Yury-MonZon/MZButtons/MZButtons/used_pins.jpg

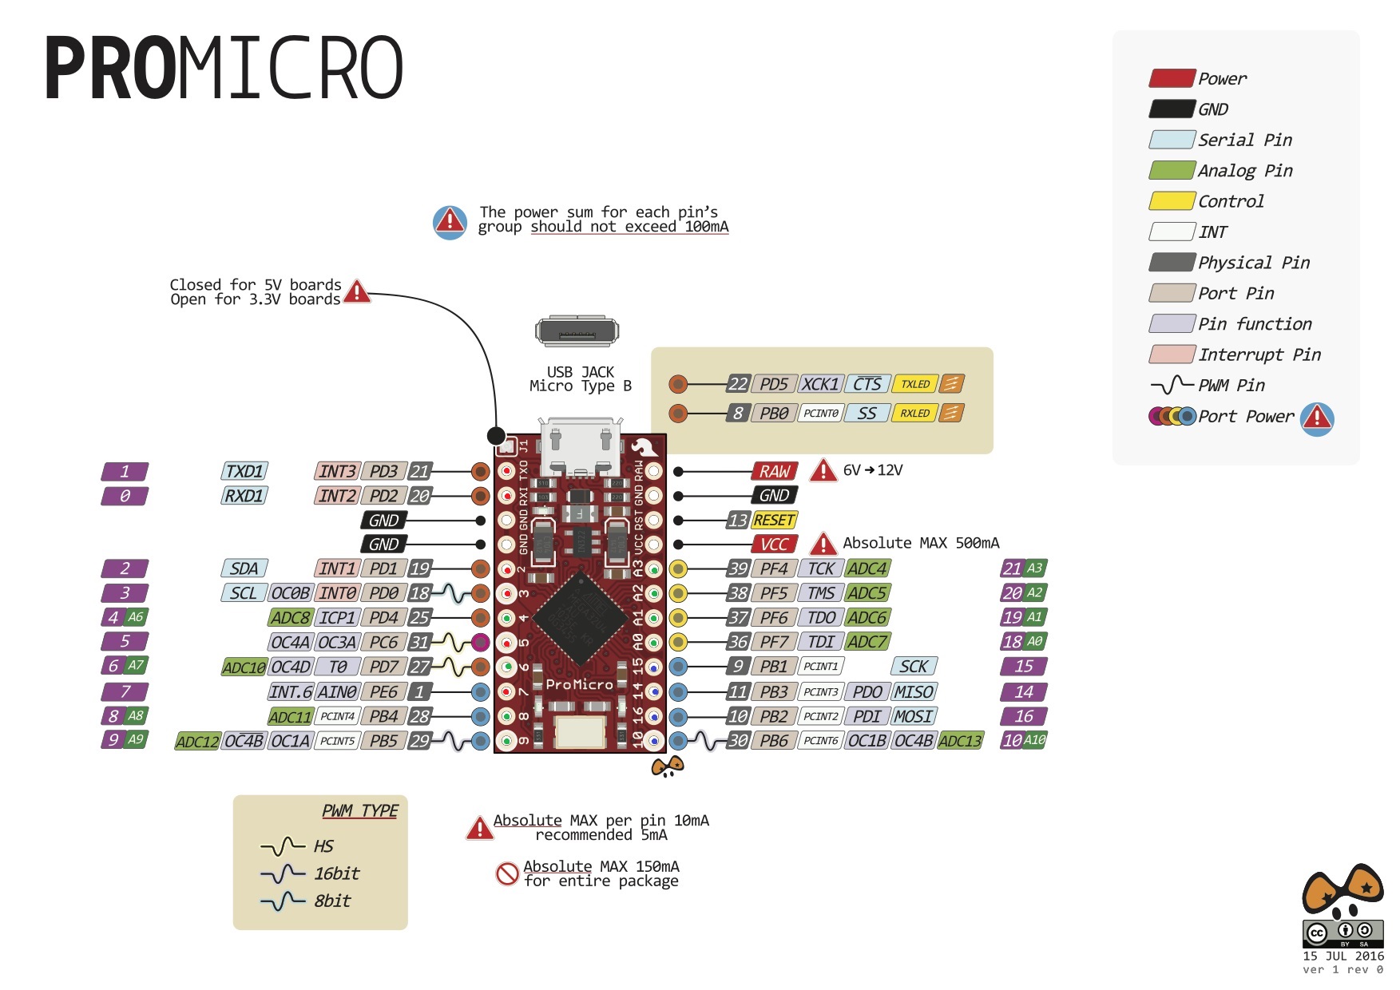
MZButtons/used_pins.jpg
