Yury-MonZon/MZButtons/Photos/IMG_20180401_122430.jpg

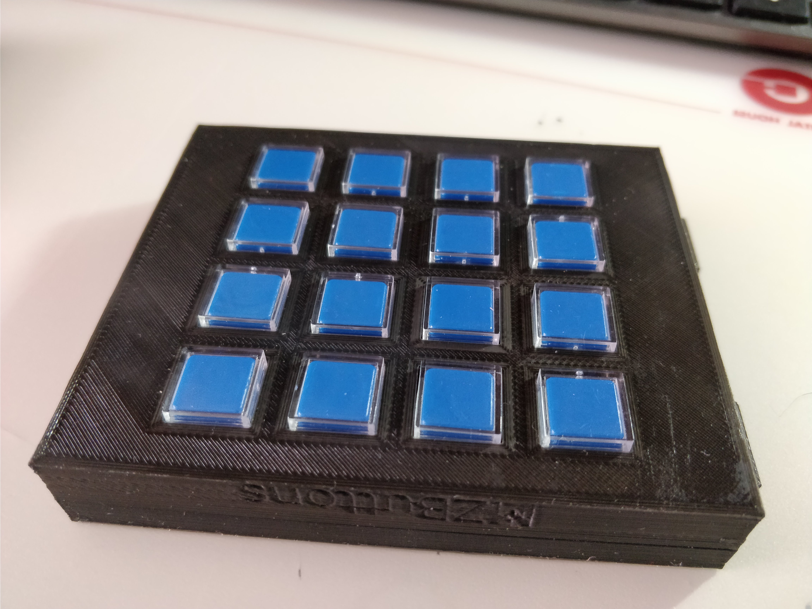
Photos/IMG_20180401_122430.jpg
