Yury-MonZon/MZButtons/Photos/IMG_20180401_122445.jpg

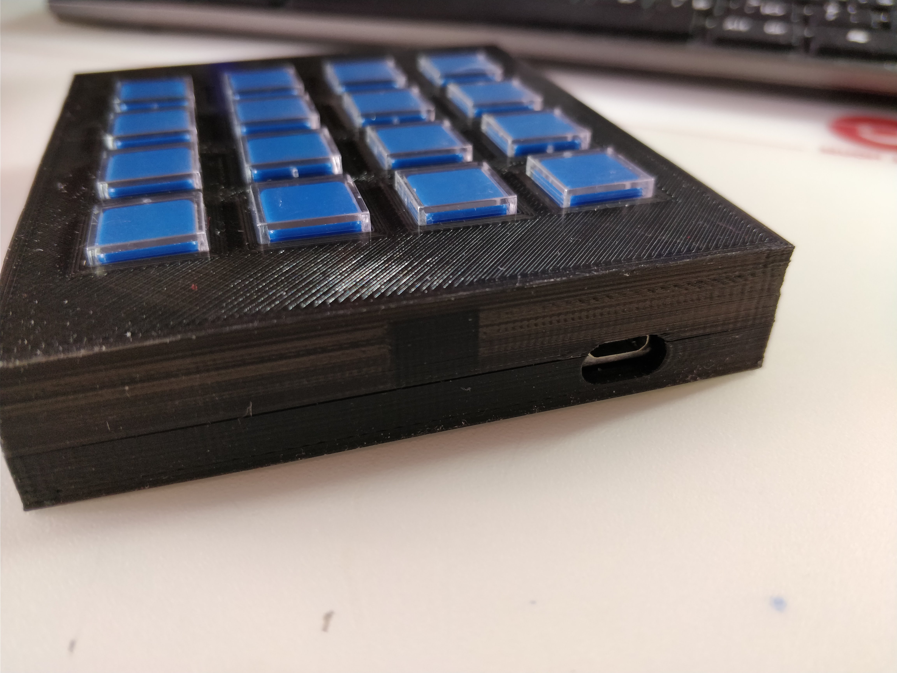
Photos/IMG_20180401_122445.jpg
