Yury-MonZon/MZButtons/Photos/IMG_20180401_122511.jpg

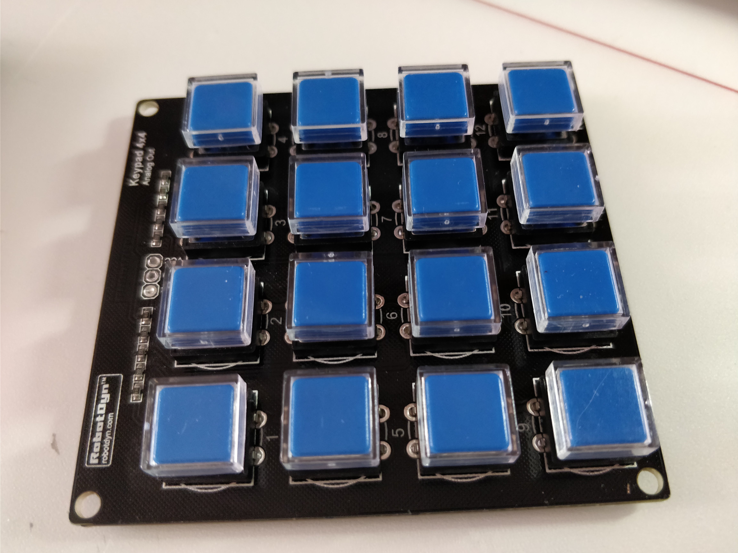
Photos/IMG_20180401_122511.jpg
