Yury-MonZon/MZButtons/Photos/IMG_20180401_122524.jpg

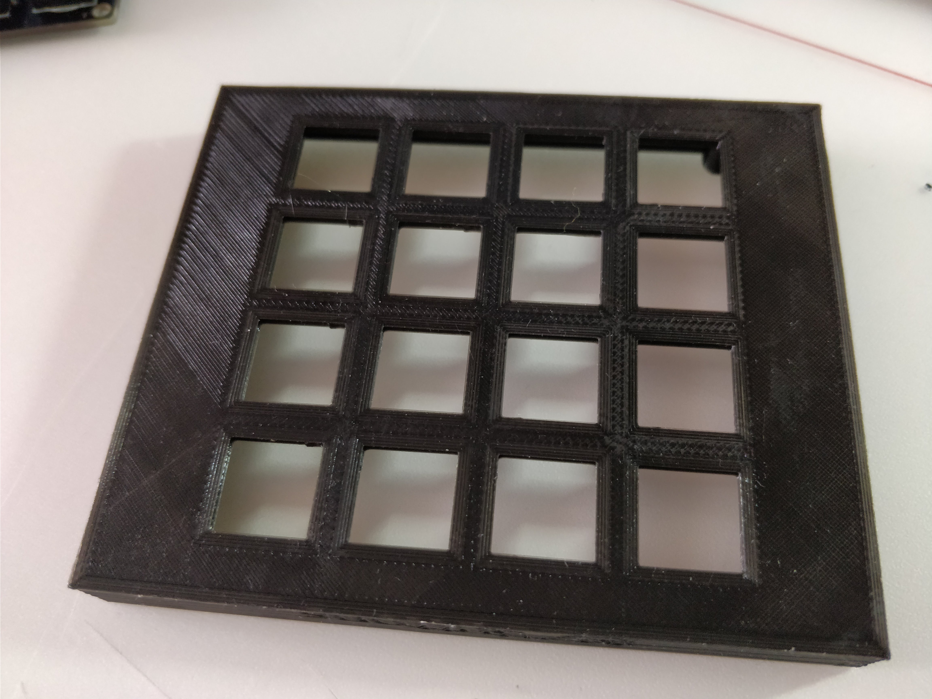
Photos/IMG_20180401_122524.jpg
