Yury-MonZon/MZButtons/Photos/IMG_20180401_122537.jpg

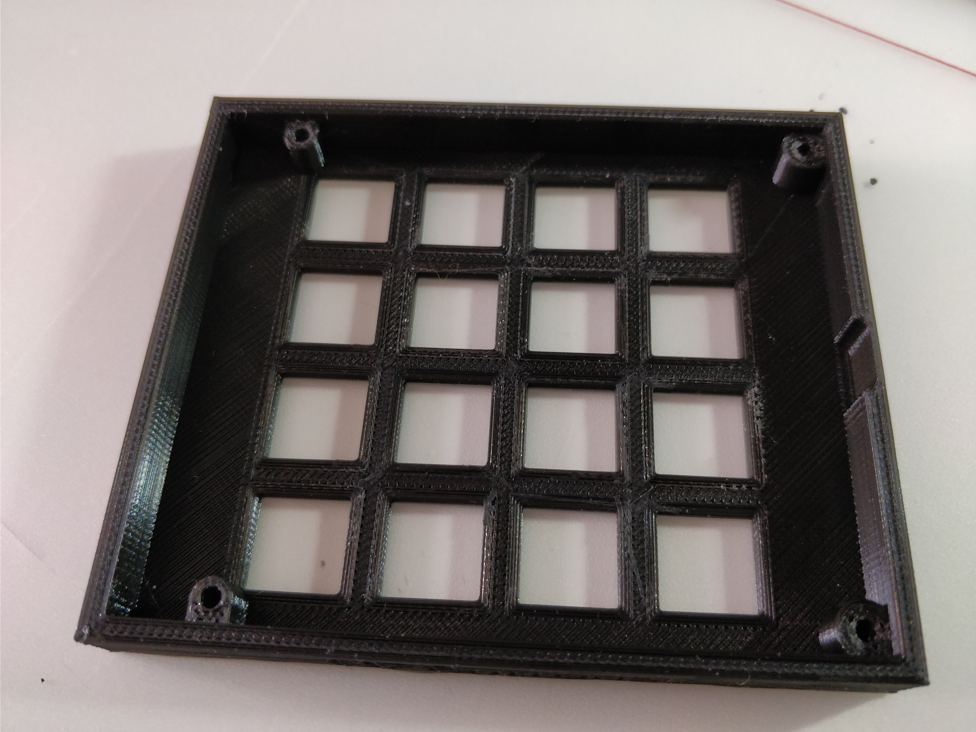
Photos/IMG_20180401_122537.jpg
