Yury-MonZon/MZButtons/Photos/IMG_20180401_122552.jpg

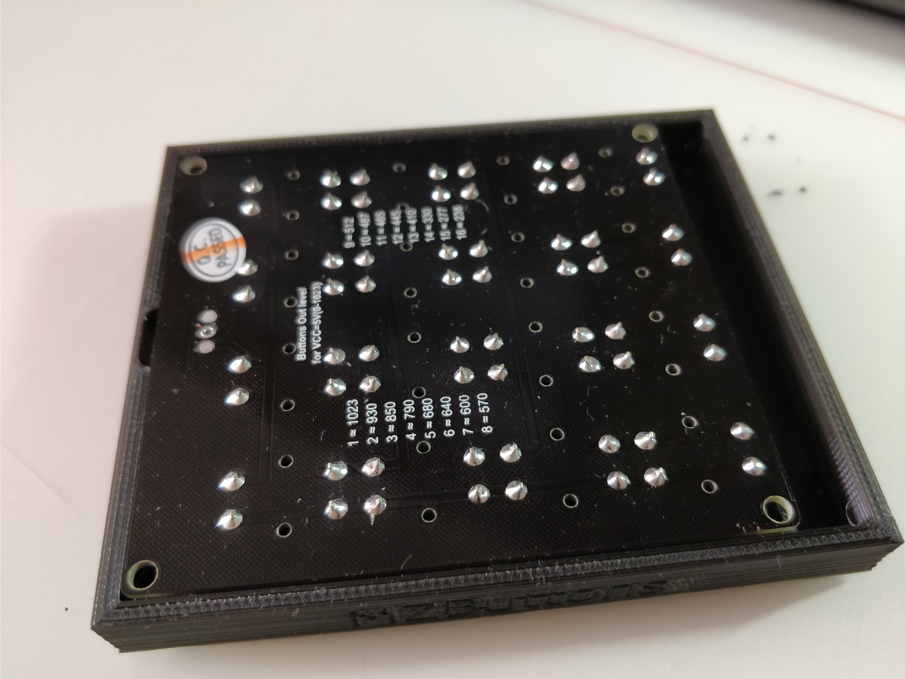
Photos/IMG_20180401_122552.jpg
