Yury-MonZon/MZButtons/Photos/IMG_20180401_133800.jpg

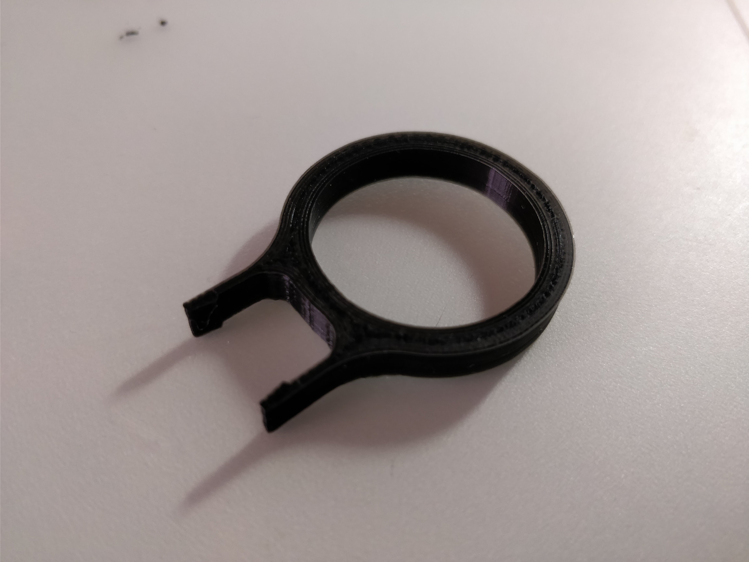
Photos/IMG_20180401_133800.jpg
