Yury-MonZon/MZButtons/Photos/IMG_20180401_133826.jpg

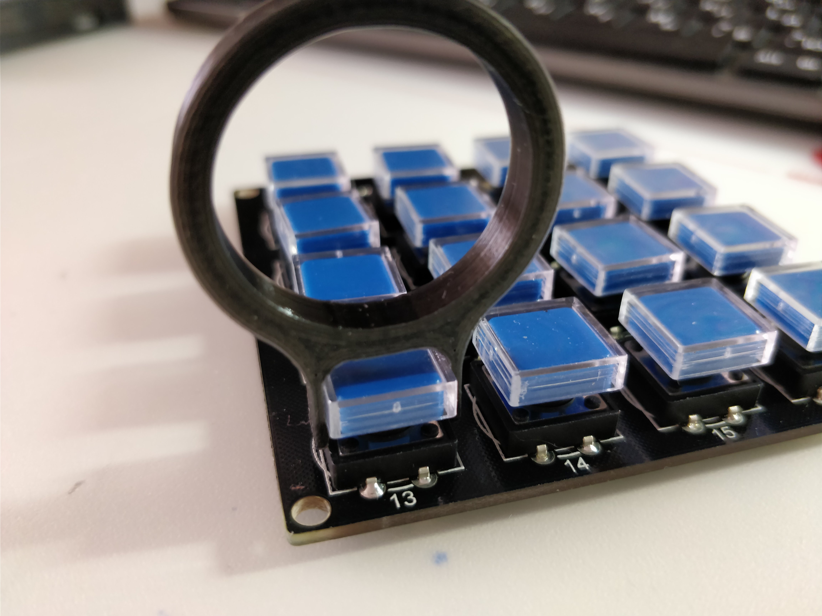
Photos/IMG_20180401_133826.jpg
