Yury-MonZon/MZButtons/Photos/IMG_20180401_141649.jpg

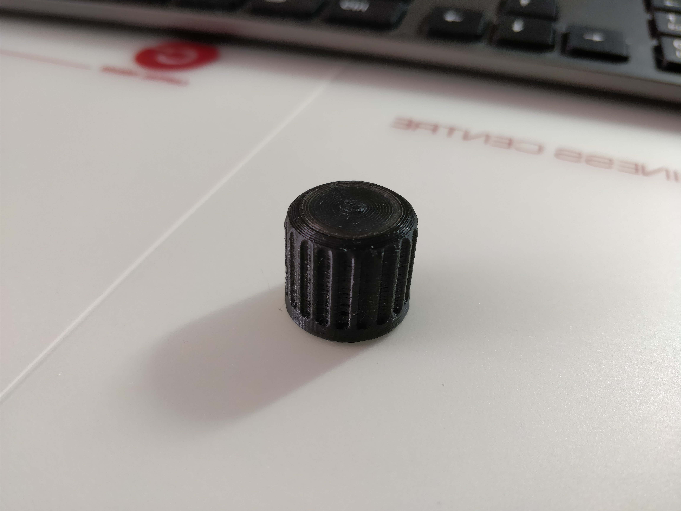
Photos/IMG_20180401_141649.jpg
