Yury-MonZon/MZButtons/Photos/IMG_20180402_002646.jpg

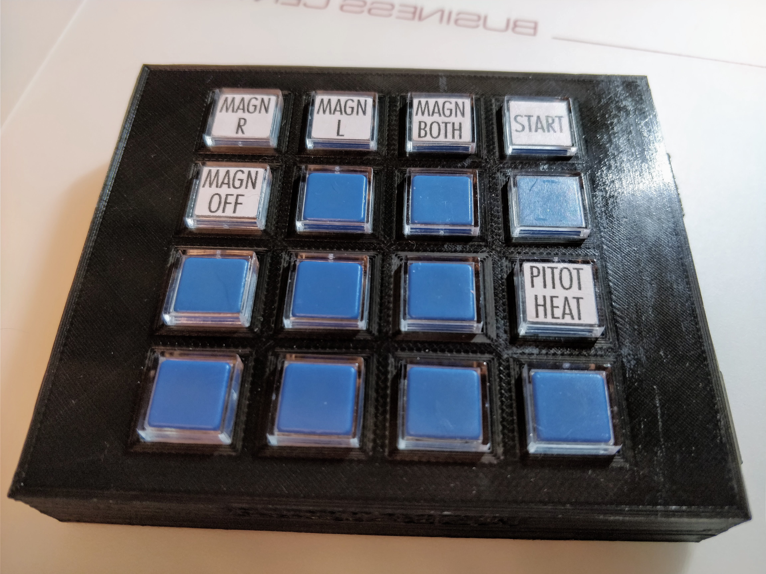
Photos/IMG_20180402_002646.jpg
