Yury-MonZon/MZButtons/Photos/IMG_20180403_205455.jpg

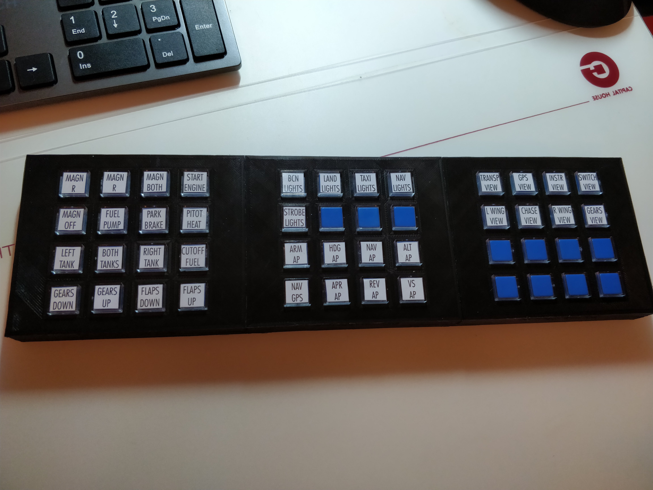
Photos/IMG_20180403_205455.jpg
