Yury-MonZon/MZButtons/Decals/Print_me.html

MAGN RIGHT | MAGN LEFT | MAGN BOTH | START ENGINE
MAGN OFF | FUEL PUMP | PARK BRAKE | PITOT HEAT
LEFT TANK | BOTH TANKS | RIGHT TANK | CUTOFF FUEL
GEARS DOWN | GEARS UP | FLAPS DOWN | FLAPS UP

BCN LIGHTS | LAND LIGHTS | TAXI LIGHTS | NAV LIGHTS
STROBE LIGHTS | SYNC HDG | X | X
ARM AP | HDG AP | NAV AP | ALT AP
NAV GPS | APR AP | REV AP | VS AP

SQWK VIEW | GPS VIEW | INSTR VIEW | SWITCH VIEW
L WING VIEW | TAIL VIEW | R WING VIEW | GEARS VIEW
ENGINE VIEW | PILOT VIEW | RADIO VIEW | X
ATC DIALOG | READ BACK | ATC FREQ | TAXI MAP

X | X | X | X
X | X | X | X
X | X | X | X
X | X | X | X

X | X | X | X
X | X | X | X
X | X | X | X
X | X | X | X

X | X | X | X
X | X | X | X
X | X | X | X
X | X | X | X

X | X | X | X
X | X | X | X
X | X | X | X
X | X | X | X
