Yury-MonZon/MZButtons/(commit log)

2018-05-27 Added source code
    Tested on my hw, let me know if you find a bug.
    [MD_REncoder.cpp, MD_REncoder.h, MZButtons.ino, config.h]
2018-05-27 Updated
    Added encoders and special thanks info
